ThrudTheBarbarian/rpusb/(commit log)

2022-04-10 Initial circuit design
    [rpusb.brd, rpusb.sch]
2022-04-11 First stab at routing the board - set up for JCLPCB
    [rpusb.brd, rpusb.sch, rpusb_eagle_bom.csv]
2022-04-11 Better routing
    [rpusb.brd]
2022-04-11 Ready to order from NextPCB
    [rpusb.brd, rpusb.sch, rpusb_eagle_bom.csv]
2022-04-12 As submitted to NextPCB
    [rpusb_centroid.csv, rpusb_eagle_bom.csv, rpusb_nextpcb_bom.csv]
